kotoba00/kensa-tag/case-bottom/renders/exploded.png

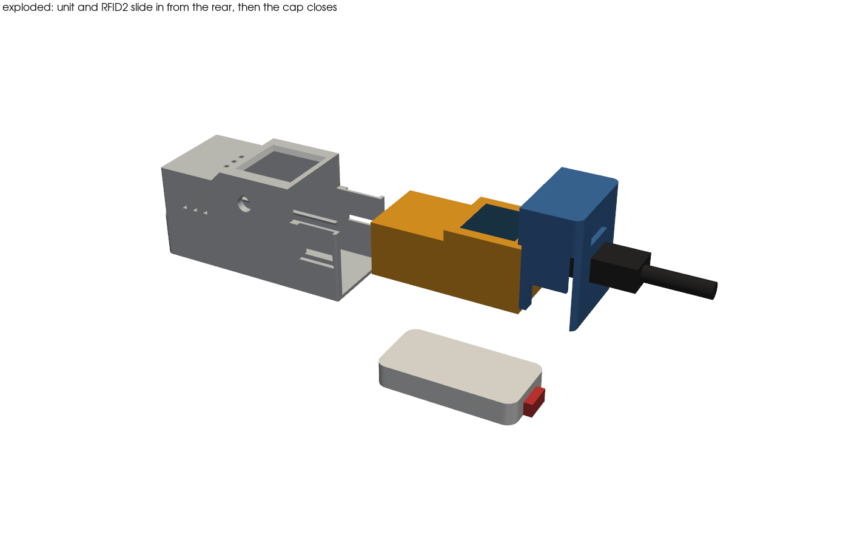
case-bottom/renders/exploded.png
