kotoba00/kensa-tag/case-bottom/renders/section_antenna.png

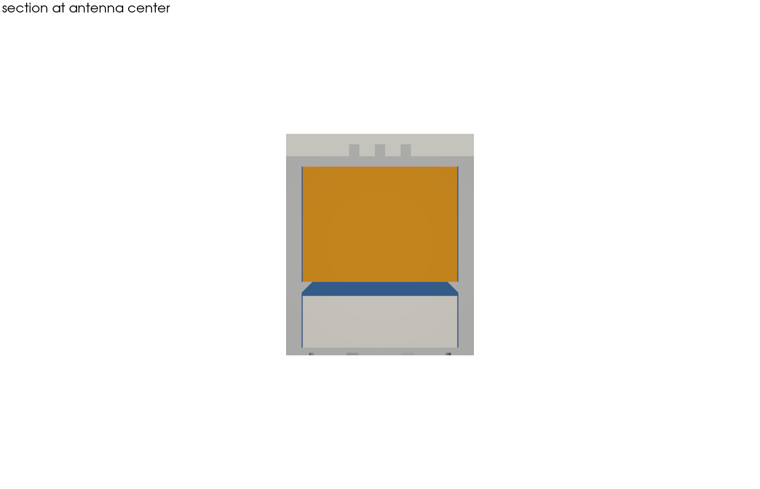
case-bottom/renders/section_antenna.png
