kotoba00/kensa-tag/case-bottom/renders/section_center.png

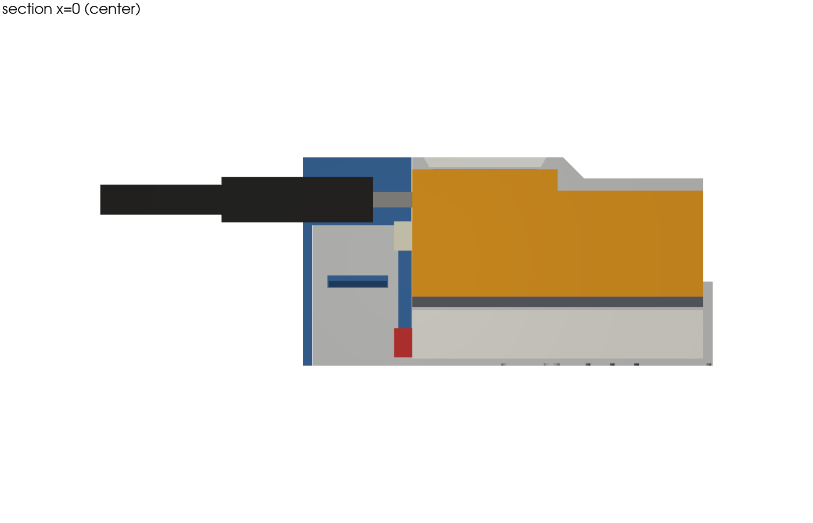
case-bottom/renders/section_center.png
