kotoba00/kensa-tag/case-bottom/renders/section_hook.png

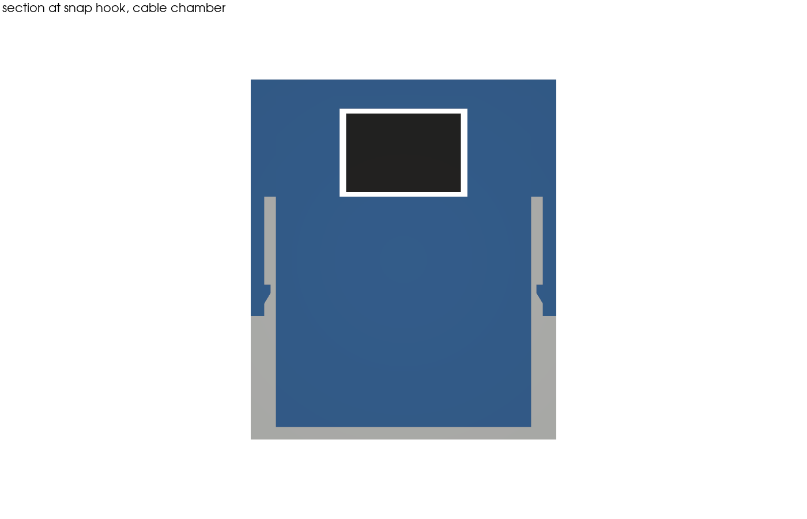
case-bottom/renders/section_hook.png
