kotoba00/kensa-tag/case-bottom/renders/section_reset.png

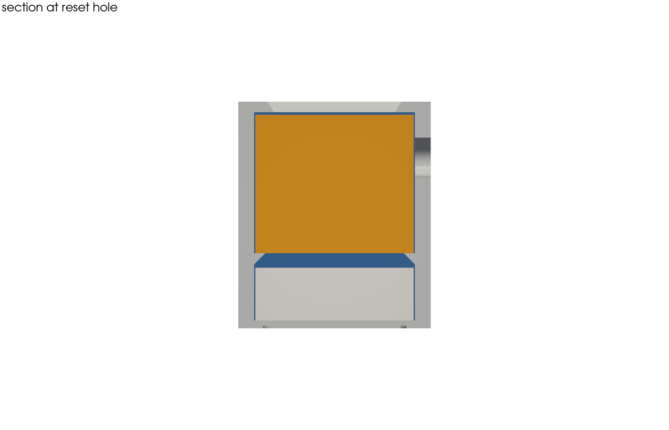
case-bottom/renders/section_reset.png
