kotoba00/kensa-tag/case-bottom/assembly.step

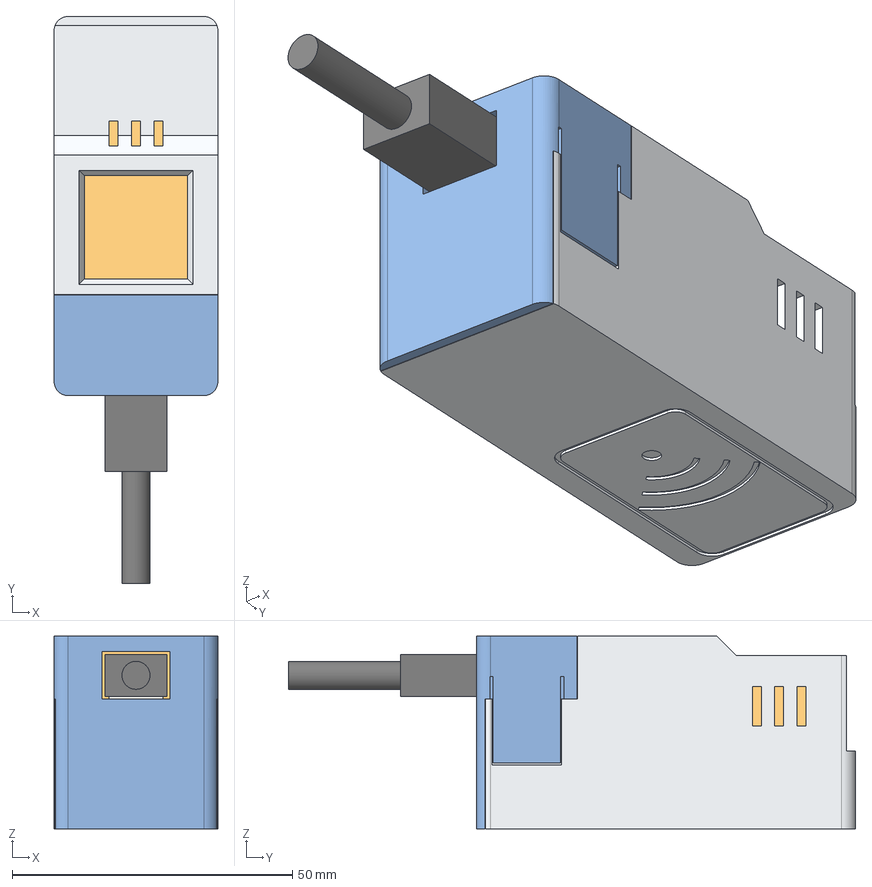
[picture p8: CAD file, 2026-11-04]
case-bottom/assembly.step
29.2 x 101.1 x 34.4 mm
tray
cap
unit
rfid2
usb_shell
usb_plug
usb_cable
grove_atom
grove_rfid
