kotoba00/kensa-tag/case-bottom/tray.step

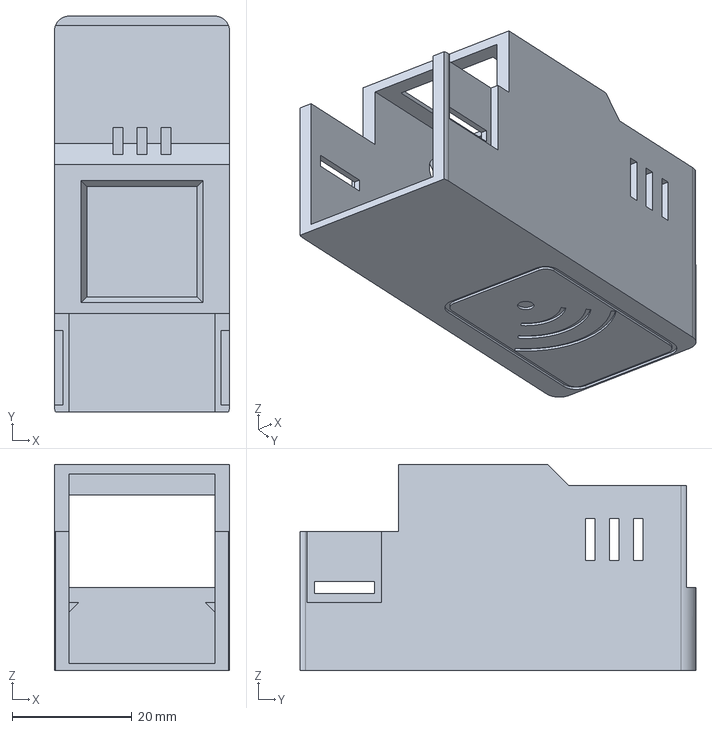
[picture p9: CAD file, 2026-11-04]
case-bottom/tray.step
29.2 x 66.0 x 34.4 mm
