kotoba00/kensa-tag/case-bottom/cap.step

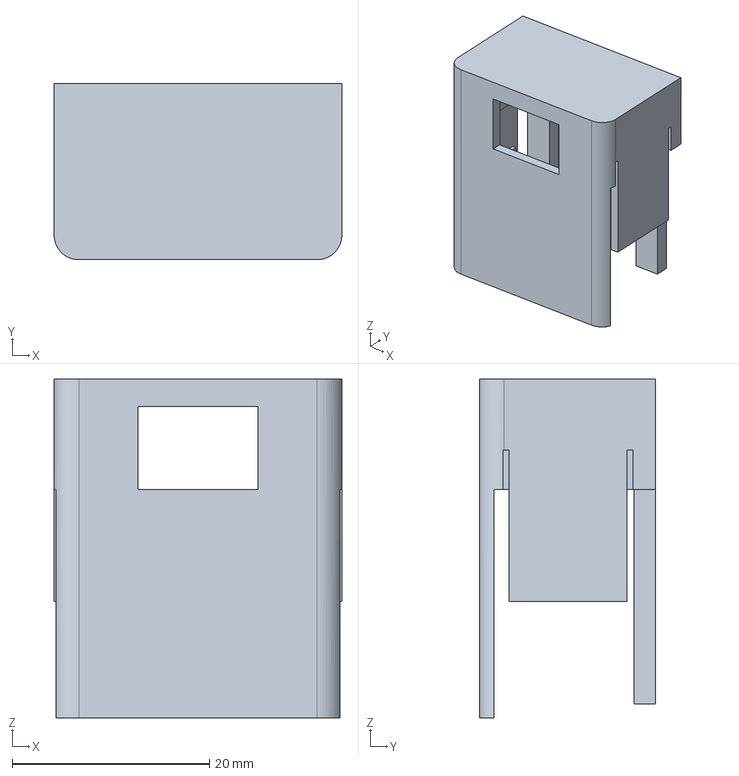
[picture p10: CAD file, 2026-11-04]
case-bottom/cap.step
29.2 x 17.9 x 34.4 mm
