kotoba00/kensa-tag/(list of files, cad)

Other CAD files:
case-bottom/cap.stl
case-bottom/tray.stl
