kotoba00/kensa-tag/case-bottom/renders/assembled_bottom.png

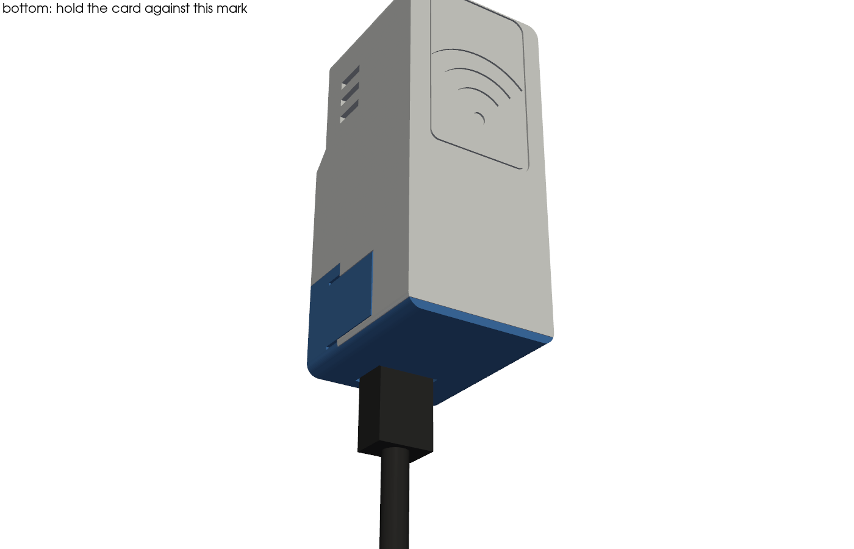
case-bottom/renders/assembled_bottom.png
