kotoba00/kensa-tag/case-bottom/renders/assembled_front.png

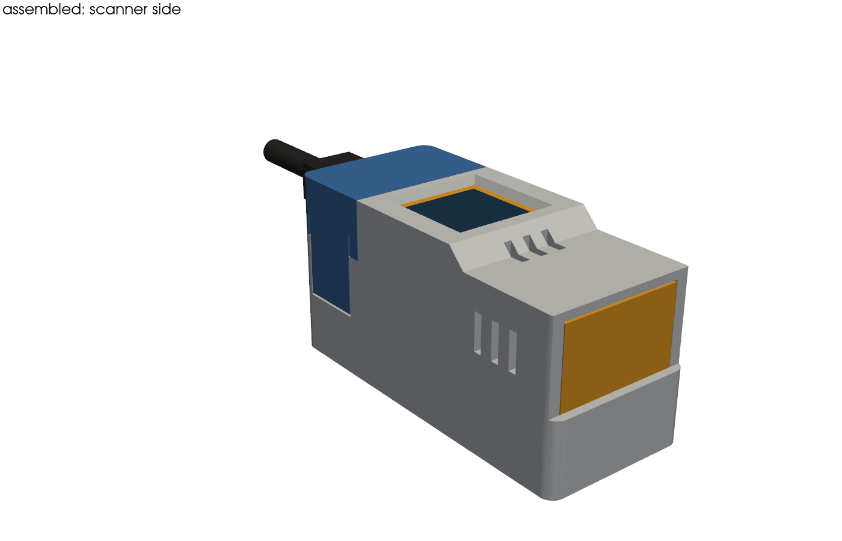
case-bottom/renders/assembled_front.png
