kotoba00/kensa-tag/case-bottom/renders/print_orientation.png

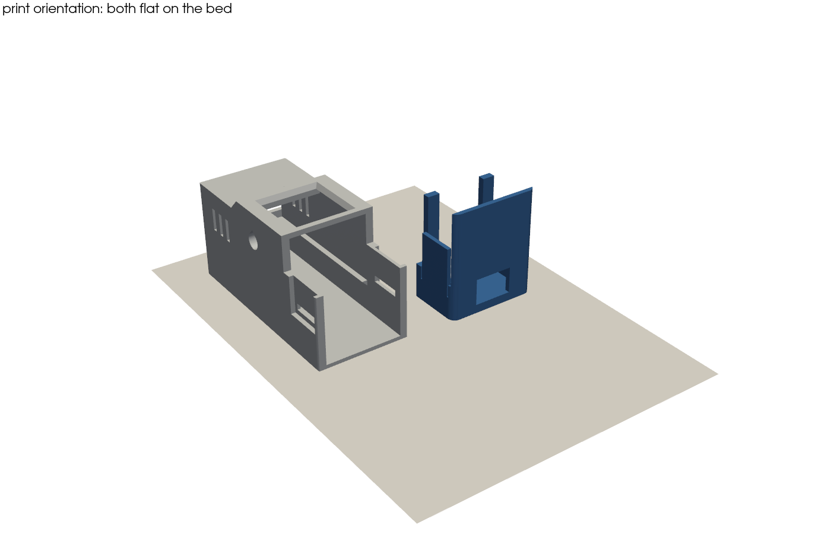
case-bottom/renders/print_orientation.png
