kotoba00/kensa-tag/(commit log)

2026-11-02 検査場タグの最初の版を追加
    検査が終わった製品は、出荷されるまで生産管理データに現れない。
    この空白を電子タグの読み取りで埋める。
    - 読み取りの履歴と、カードと注文の紐付けを記録する
    - かざし忘れ、滞留、数量、分納の合計の4種を検出する
    - 検出結果の原因と優先順位を Claude に考えてもらう
    - 入力欄で読み取る画面を追加する
    - AtomS3R と Unit RFID2 を USB キーボードとして動かす
    データは架空のもののみ。
2026-11-03 分納番号をエレベーター前の自動採番にし、工程を設定で持つ
    プレスでは注文番号とカードの紐付けだけを行い、分納番号はエレベーター前で読んだ順に振る。
    手打ちと仮番号は廃止した。工程は app/flow.json の一覧で持ち、読み取りに工程と開始・終了を記録する。
    数量は生産日報が入るまで未定として扱い、検出結果は日本語の文章で出す。
2026-11-03 読み取り機を1台で QR とカードに対応させる
    AtomS3R に Atomic QRCode2 Base の読み取りを足し、画面のボタンを押している間だけ QR を読む。
    実機で UID の途中に空白が入ったので、判定の前に空白を落とす。
    API キーはリポジトリの外のファイルから uvicorn の --env-file で読む。
2026-11-03 見立てを裏で先に作る
    検出結果が変わったときだけ Claude に聞き直し、画面は保存済みの見立てをすぐ出す。
    見立てに検出結果の指紋を残し、古いか作り直し中かを画面に出す。
2026-11-03 かざして調べるモードと実演用の記録票
    画面の「調べる」でカードをかざすと、記録せずに注文・分納・今の場所を出す。
    スマホ向けに /t/カードの番号 で同じ中身を出す。
    実演用に架空の注文 100108・100109 と、右上に 20mm 角の QR を載せた生産指示記録票を足す。
2026-11-03 読み取り機だけの工程向けに Wi-Fi 版と付け替えの警告
    現場の工程にはモニターが無いため、読み取り機から直接サーバーへ送り、
    結果を本体の画面に出す Wi-Fi 版のファームを足す（USB 版も残す）。
    本体は時計を持たないので、読んでからの経過時間を送りサーバーが時刻を付ける。
    送れない読み取りは本体にためて順に送り直す。サーバーは mDNS か IP で探す。
    使用中のカードをプレスで別の注文に付け替えるときは警告し、
    少し置いてもう一度かざしたときだけ付け替える。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
2026-11-03 Wi-Fi の設定ファイルの写しも git に入れない
2026-11-04 工場図のライブダッシュボード
    /board に工場の図を出し、分納1つを点にして最後に読んだ工程の区画に置く。
    2秒おきに読み直し、かざすと点が次の区画へ動いて光る。
    色は順調・確認が要る・Claude が今日中と見立てたものの3つ。点を押すと見立てを出す。
    区画と設備の配置は flow.json の zone と map で持つ。狭い区画では点を小さくして詰める。
2026-11-04 工程名を見直し、仕上を追加。工場図を簡略レイアウトに
    - 工程: プレス・エレベーター・仕上・社内検査・社外検査・出荷検査・包装
    - 工場図: 1階 プレス/エレベーター、2階 2x2、外に社外検査。点と文字を大きく
    - リーダー: 工程一覧を取り直したとき、選択中の工程名も更新する
2026-11-04 開始と終了は読んだ順で決める。工場図で開始と終了を見分ける
    - 1回目が開始、開始のあとが終了。間違えてももう一度読めば開始に戻る
    - 二度読み（10秒以内）は開始か終了かを問わず数えない
    - リーダーと画面の工程選びは工程ごとに1つ。リーダーは開始=緑、終了=青
    - 工場図: 開始は塗りつぶし＋▶、終了は白抜き＋✓、区画に件数
2026-11-04 公開向けに README を書き直し、読み取り機の筐体を追加
    - README: なぜ作ったか・7工程・Claude の見立て・画面・ファイル一覧、工場図の画面写真
    - case-bottom: 底面でカードを読む3Dプリント筐体（CadQuery、STL・STEP・レンダ）
    [assembly.step, cap.step, cap.stl, tray.step, tray.stl]
2026-11-04 README: 社外検査は渡す日に開始、納品で終了
2026-11-04 MIT ライセンスを追加
2026-11-05 内職依頼: かざした分納を選ぶだけで依頼を入れ、工場図と検出で突き合わせる
    - /naishoku: 内職さんを選び、社外検査でかざした分納を押して納期を入れる
    - 工場図の社外検査を内職さんごと・入力待ち・納品済みに分ける
    - 検出を3つ追加（入力待ち・内職さんの納期切れ・依頼とカードの食い違い）
    - 滞留は内職さんの所にある間は数えず、納品の日から数え直す
2026-11-05 社外検査の区画を検査A〜Cに改名し、工場図を縦に伸ばす
2026-11-05 社内検査を開始・終了に、包装の終了でカードを外す
    - 社内検査はかざして開始、もう一度かざして終了にした
    - 「検査が終わった」は社内検査の終了か社外検査の終了で決め、検出の基準にした
    - 滞留は、検査が終わったのに出荷検査が始まらないものにした
    - 包装の終了で紐付けを閉じ、カードを使い回せるようにした
    - 分納番号は、その時点までに出荷した番号も避けて振るようにした
2026-11-05 記録票の工程欄を今の7工程に合わせる
    - 裁断・プレス・仕上・社内検査・社外検査・出荷検査・包装の7行にした
    - 行と確認印を少し小さくして、A5 に収めた
2026-11-06 内職さんの専用ページで進捗を選べるようにする
    - /w/鍵 で内職さん本人が 未着手・ちぎり済・検査済 を選ぶ（納品前は選び直せる）
    - 工場図はちぎり済を◐、検査済を✓で出す
    - 検査済なのに引き取っていないものを「引き取り待ち」として検出（8種）
    - 検査済にした分は内職さんの納期切れにしない
2026-11-07 確認が要るものの種類ラベルを8種すべて日本語にする
    内職まわりで足した4種が英語の内部名のまま出ていた。名前は README の検出表に合わせる。
2026-11-08 README の見出しを提出名 ProcessTag にそろえる
